hardikrawat910-byte/smart-solar-bank/docs/images/pack_and_saft_cells.jpg

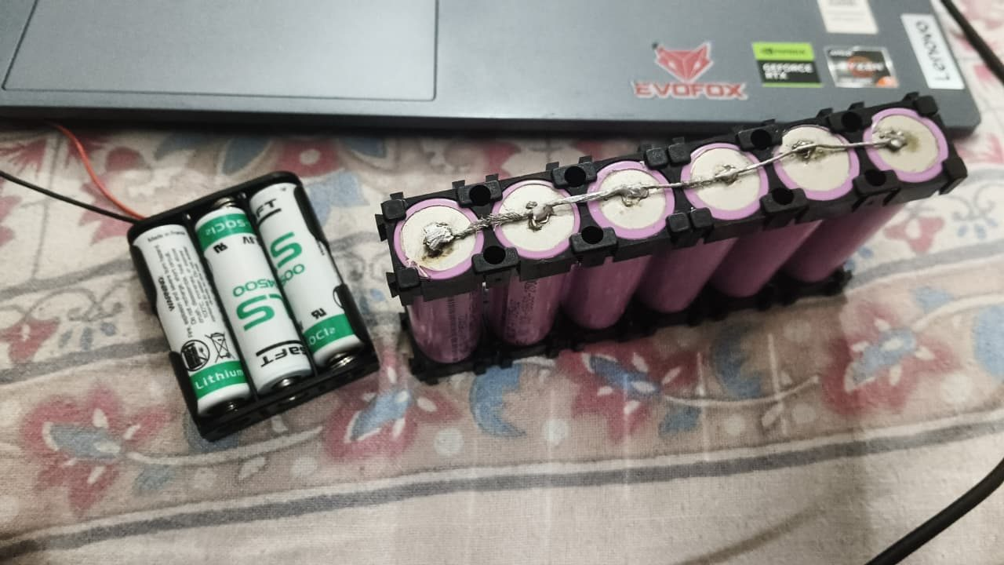
docs/images/pack_and_saft_cells.jpg
