hardikrawat910-byte/smart-solar-bank/docs/images/serial_monitor_working.jpg

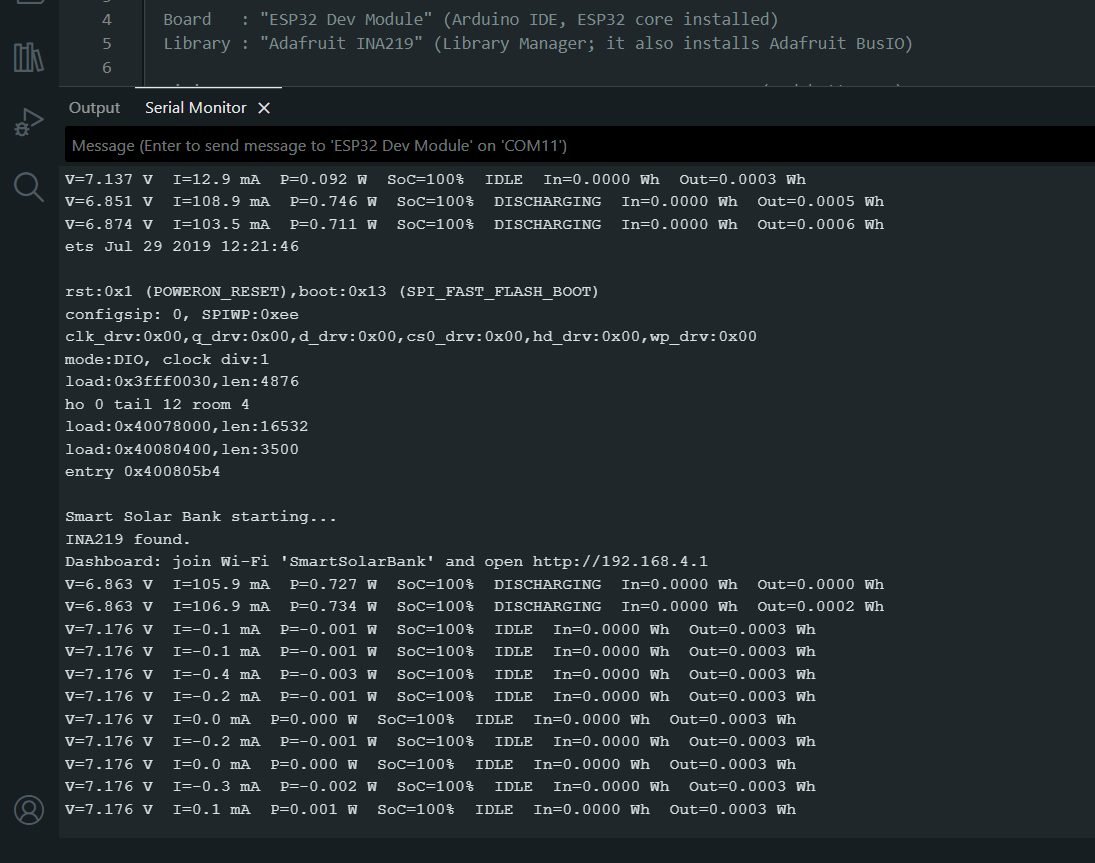
docs/images/serial_monitor_working.jpg
