hardikrawat910-byte/smart-solar-bank/(commit log)

2026-10-09 Add ESP32 blink test and INA219 I2C scanner
    Claude-Session: https://claude.ai/code/session_01LM6eX8d7eE2LMZS3NBMFqz
2026-10-09 Add Smart Solar Bank firmware with Wi-Fi dashboard
    ESP32 + INA219 monitor for a 2S3P 18650 pack: voltage, current, power,
    sag-corrected charge %, Wh in/out, time left, and fault alerts.
    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
    [smart_solar_bank.ino]
2026-10-09 Add hardware photos, serial captures and circuit diagram
    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
2026-10-09 Add SUNVOLT firmware with live graphs; keep v1 sketch as legacy
    SUNVOLT targets the 1S 5200 mAh pack: battery INA219 at 0x40, optional
    solar INA219 at 0x41, 30-minute graph history, CSV export, and an
    offline dashboard that draws its own charts.
    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
2026-10-09 Add v2 photos and dashboard preview; mark v1 circuit diagram
    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
2026-10-09 Document the v2 build: 1S pack, power bank board, CN3791 solar
    Rewrite README, hardware and how-it-works for the current build, add
    v2 problems to troubleshooting, and keep v1 as a reference section.
    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
